williamdnelson10-bot/custom-loudspeakers/Photos/Misc/front_speaker1.jpeg

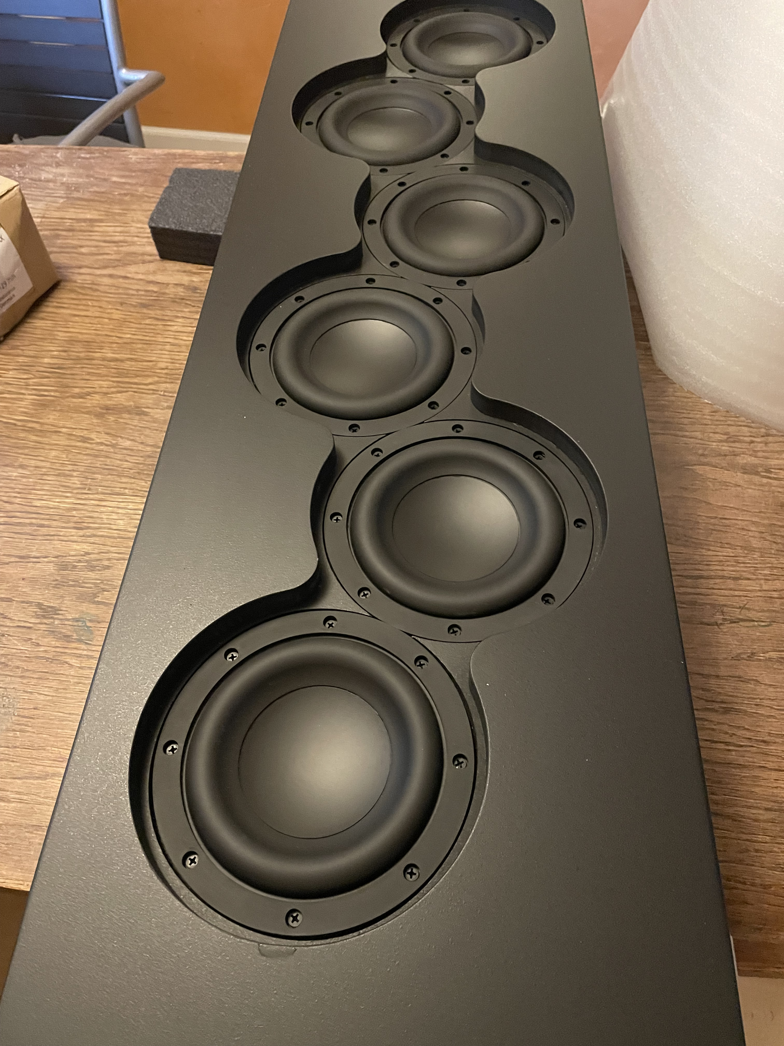
Photos/Misc/front_speaker1.jpeg
