williamdnelson10-bot/custom-loudspeakers/Photos/Misc/IMG_4796.jpeg

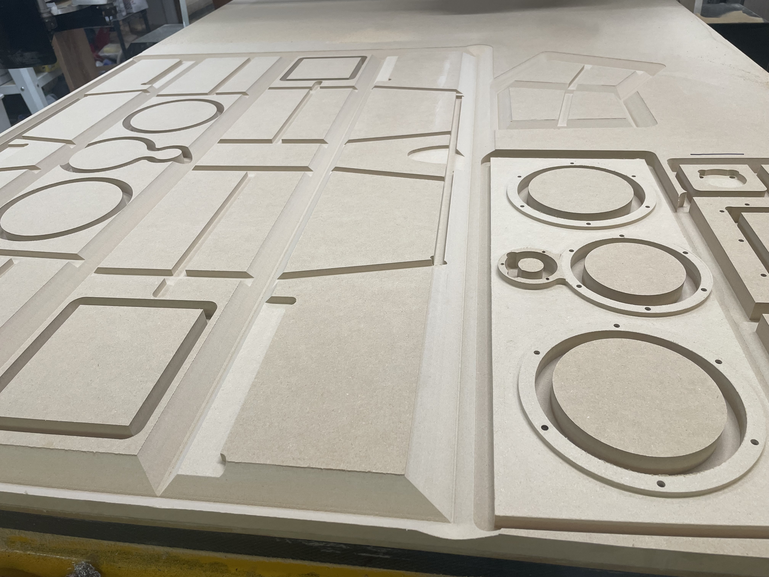
Photos/Misc/IMG_4796.jpeg
