williamdnelson10-bot/custom-loudspeakers/Photos/Misc/IMG_4868.jpeg

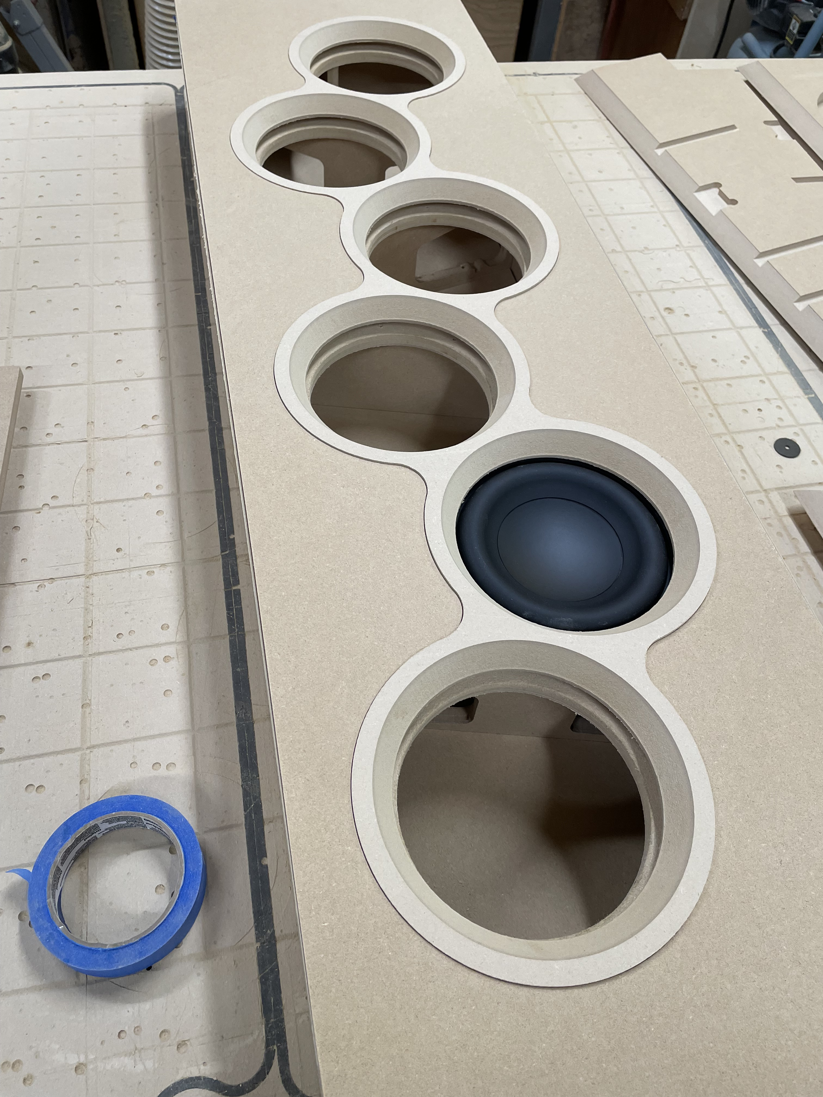
Photos/Misc/IMG_4868.jpeg
