williamdnelson10-bot/custom-loudspeakers/Photos/Misc/IMG_4891.jpeg

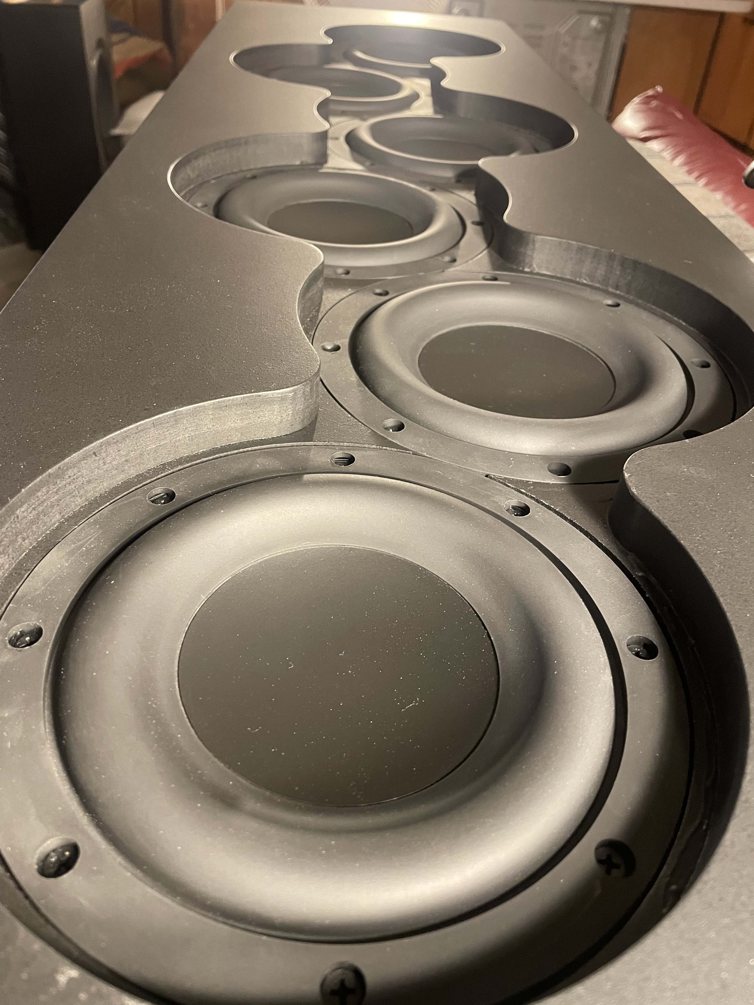
Photos/Misc/IMG_4891.jpeg
