williamdnelson10-bot/custom-loudspeakers/Photos/Misc/IMG_4894.jpeg

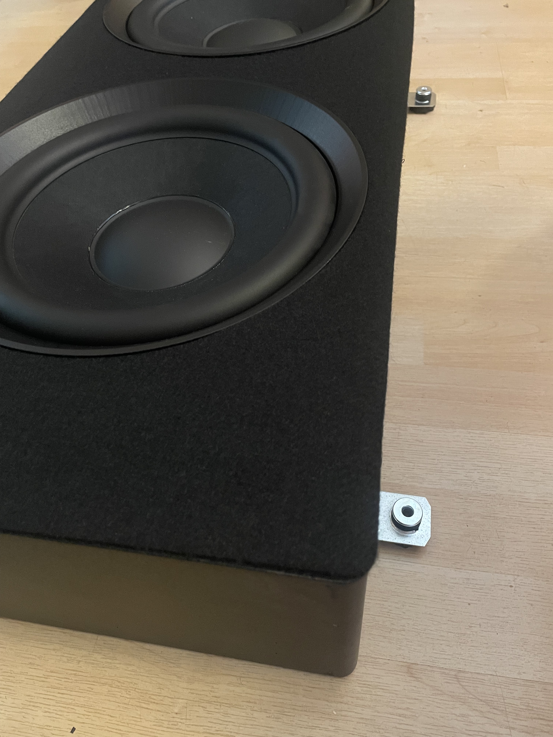
Photos/Misc/IMG_4894.jpeg
