williamdnelson10-bot/custom-loudspeakers/Photos/Misc/IMG_4895.jpeg

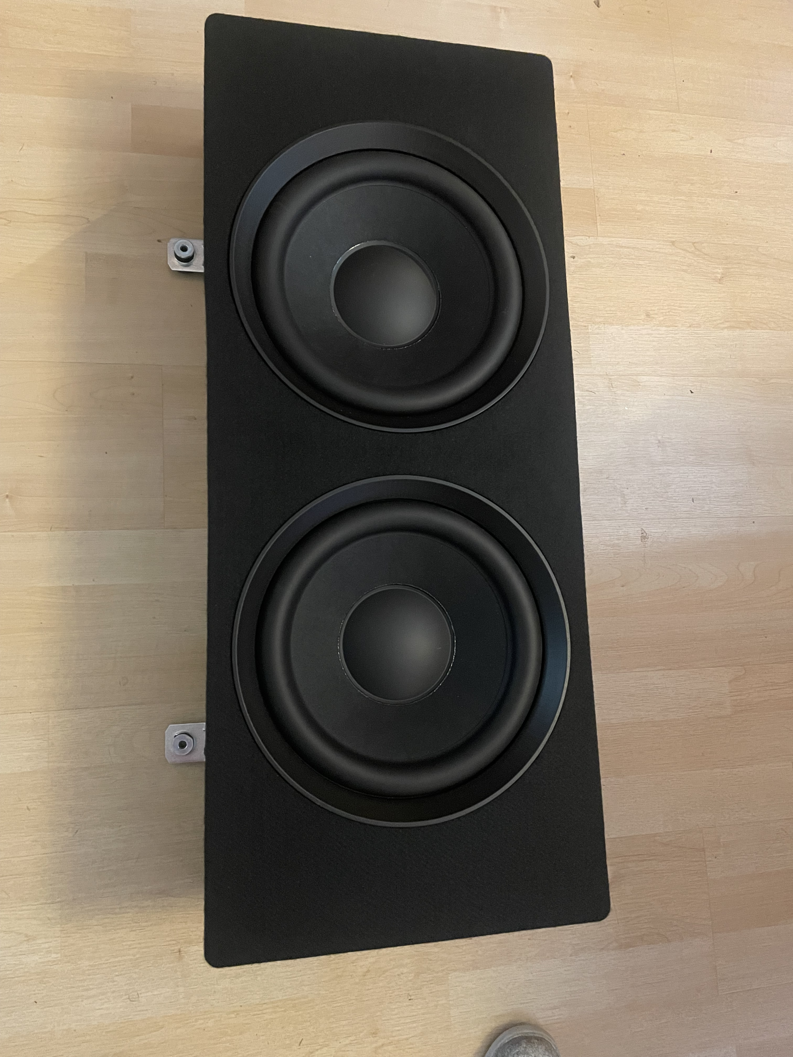
Photos/Misc/IMG_4895.jpeg
