williamdnelson10-bot/custom-loudspeakers/Photos/Misc/IMG_4914.jpeg

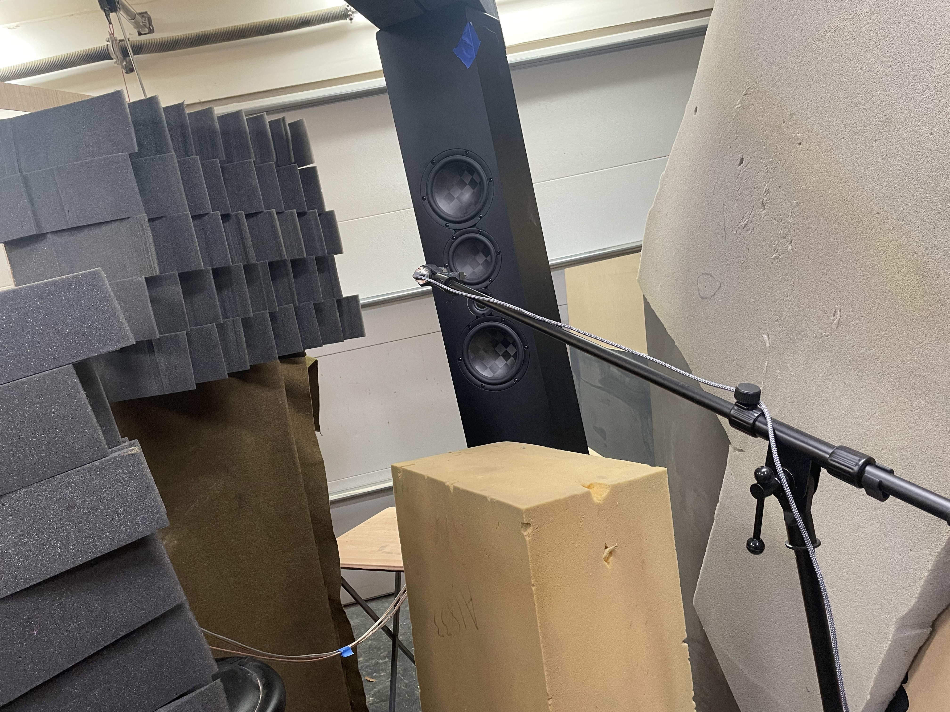
Photos/Misc/IMG_4914.jpeg
