williamdnelson10-bot/custom-loudspeakers/Photos/Misc/IMG_4917.jpeg

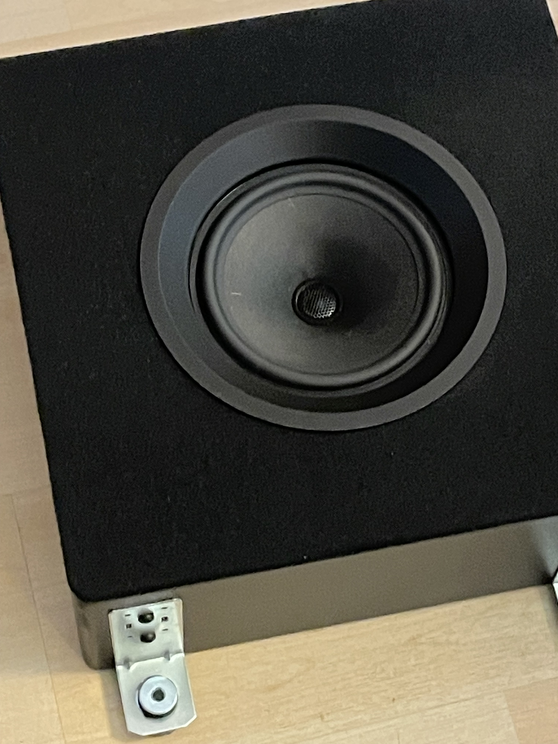
Photos/Misc/IMG_4917.jpeg
