williamdnelson10-bot/custom-loudspeakers/Photos/Misc/IMG_4919.jpeg

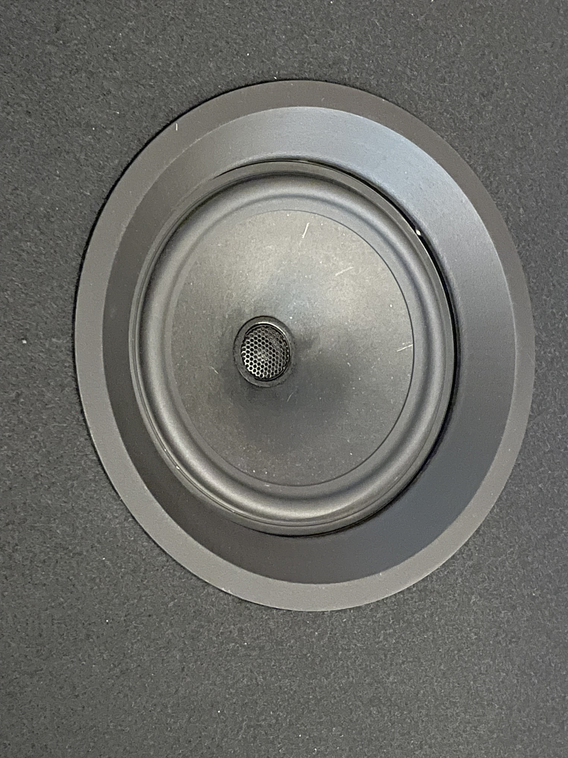
Photos/Misc/IMG_4919.jpeg
