williamdnelson10-bot/custom-loudspeakers/Photos/Misc/IMG_4920.jpeg

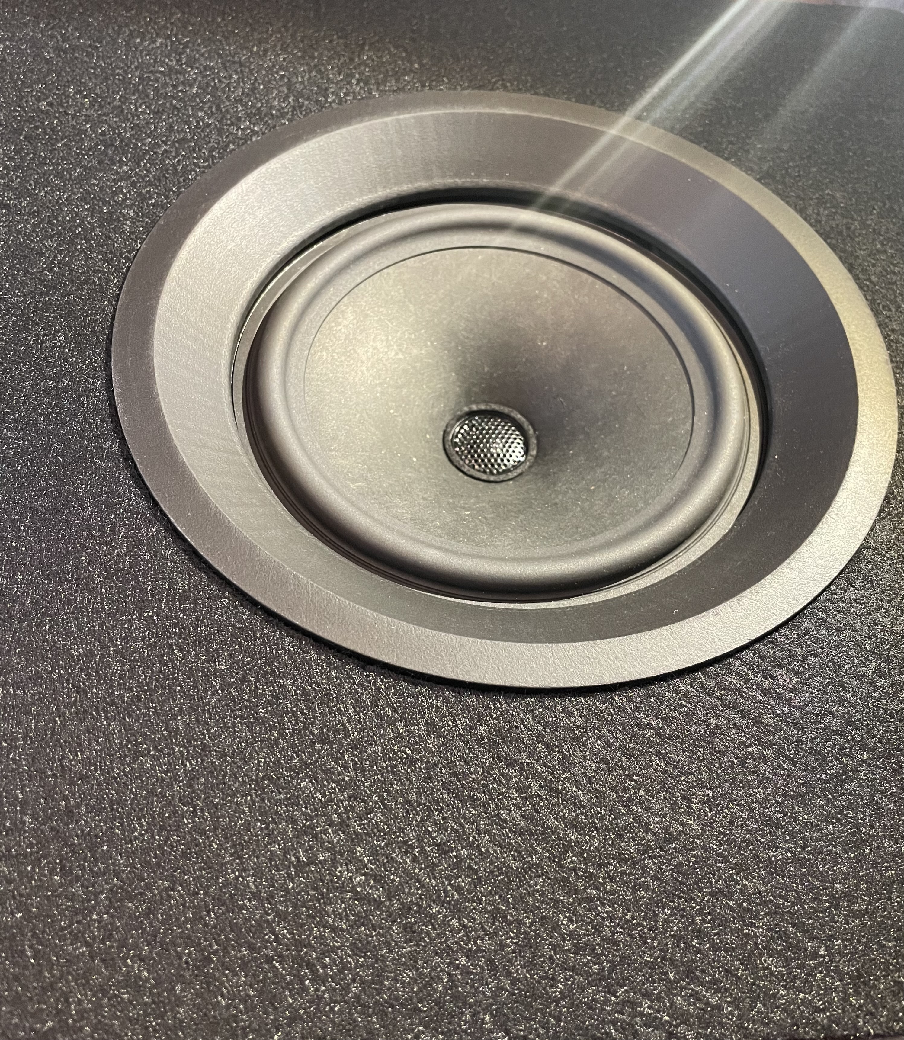
Photos/Misc/IMG_4920.jpeg
