williamdnelson10-bot/custom-loudspeakers/Photos/Misc/IMG_4924.jpeg

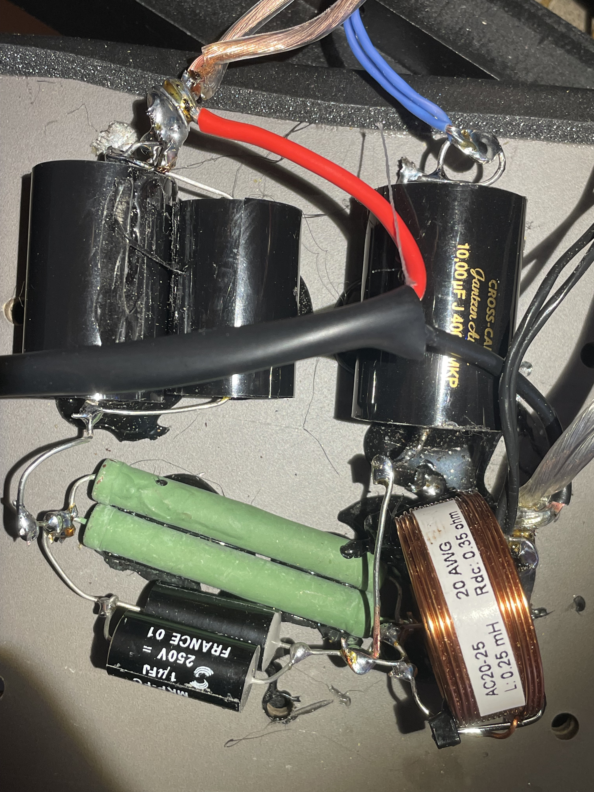
Photos/Misc/IMG_4924.jpeg
