williamdnelson10-bot/custom-loudspeakers/Photos/Misc/IMG_4925.jpeg

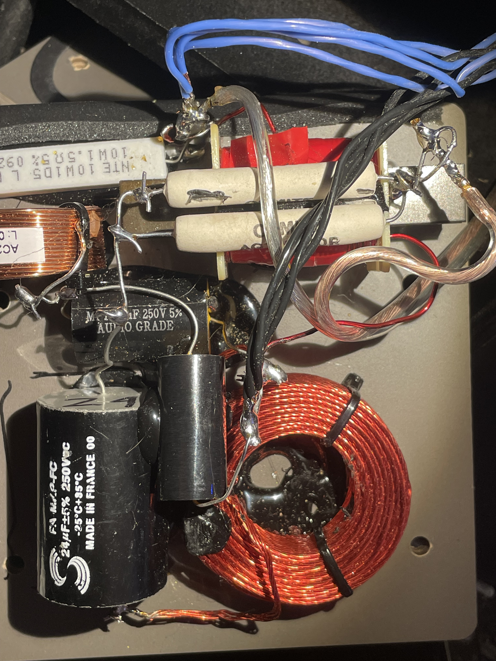
Photos/Misc/IMG_4925.jpeg
