williamdnelson10-bot/custom-loudspeakers/Photos/Misc/IMG_4938.jpeg

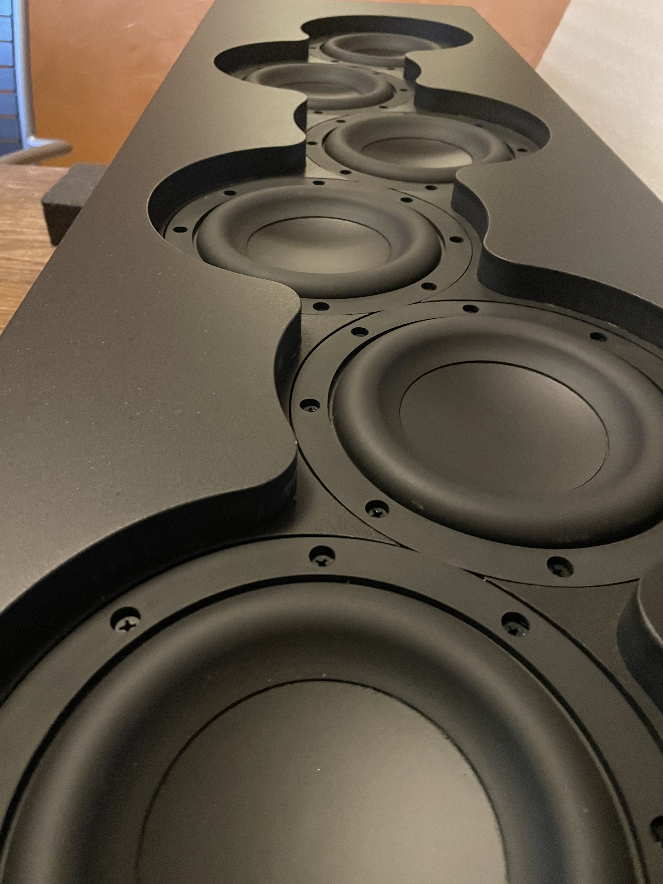
Photos/Misc/IMG_4938.jpeg
