williamdnelson10-bot/custom-loudspeakers/Photos/Misc/IMG_5594.jpg

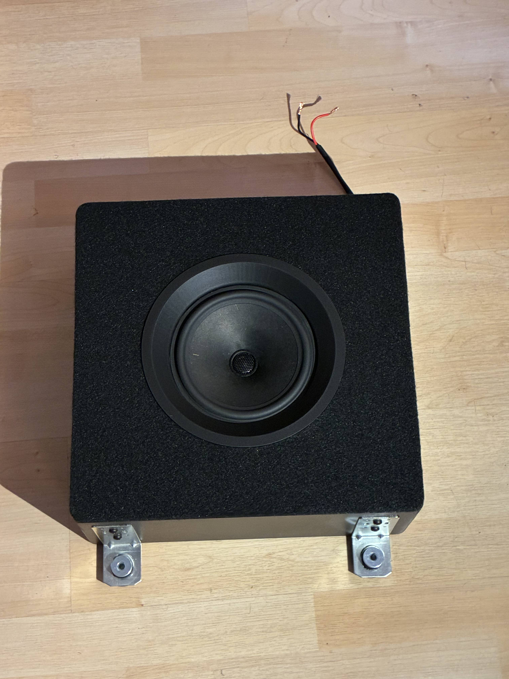
Photos/Misc/IMG_5594.jpg
