williamdnelson10-bot/custom-loudspeakers/Photos/Misc/IMG_5603.jpg

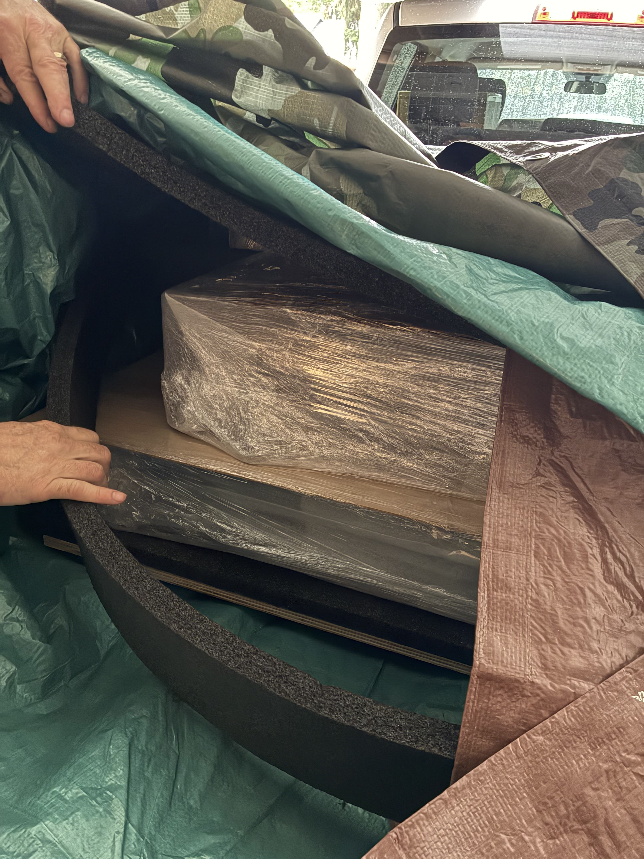
Photos/Misc/IMG_5603.jpg
