williamdnelson10-bot/custom-loudspeakers/Solidworks Files/SB6 Sur.SLDASM

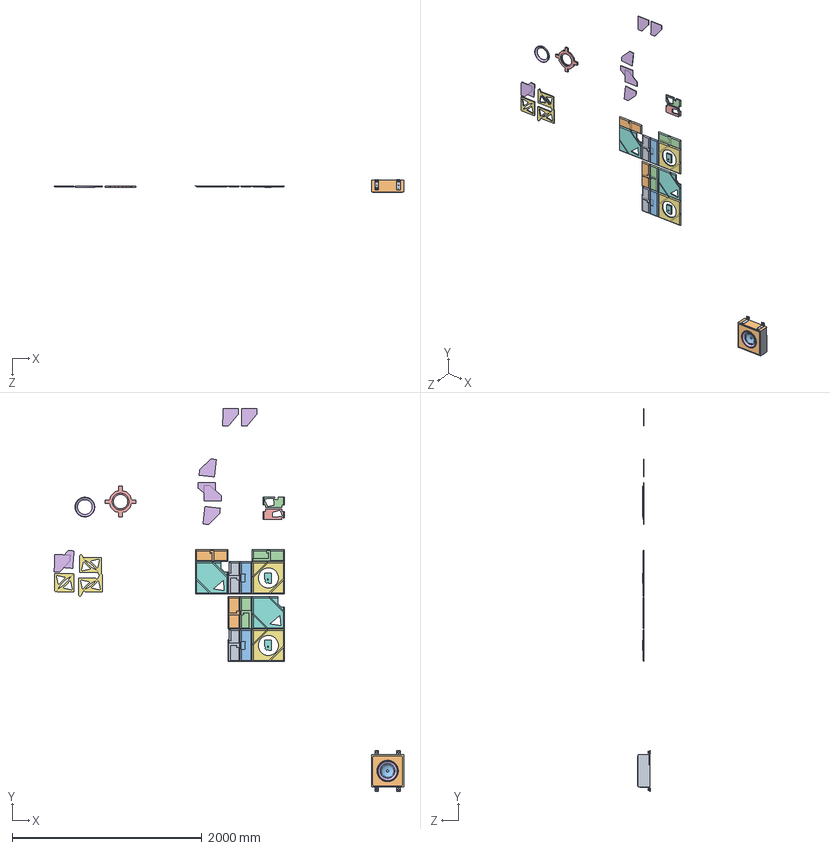
[picture p39: CAD file, 2026-11-06]
Solidworks Files/SB6 Sur.SLDASM
3684.7 x 4034.4 x 137.4 mm
SB6 Sur Back x 2
SB6 Sur Front x 3
SB6 Sur RIng x 2
SB6 Driver ring x 2
SB6 Sur Bottom x 3
SB6 Sur Side x 3
SB6 Sur Top x 3
SB6 Sur Side2 x 3
Sur BP Plate x 3
SB6 XOB Ring x 7
SB6 XO Board x 9
SB6 Sur Brace1 x 2
SB6 Sur Brace2 x 2
SB16 6in Coax
SB6 Sur Pad
PAC Intl RSIC-DC04 Bracket x 4
