williamdnelson10-bot/custom-loudspeakers/Solidworks Files/SB6 XO Board.SLDPRT

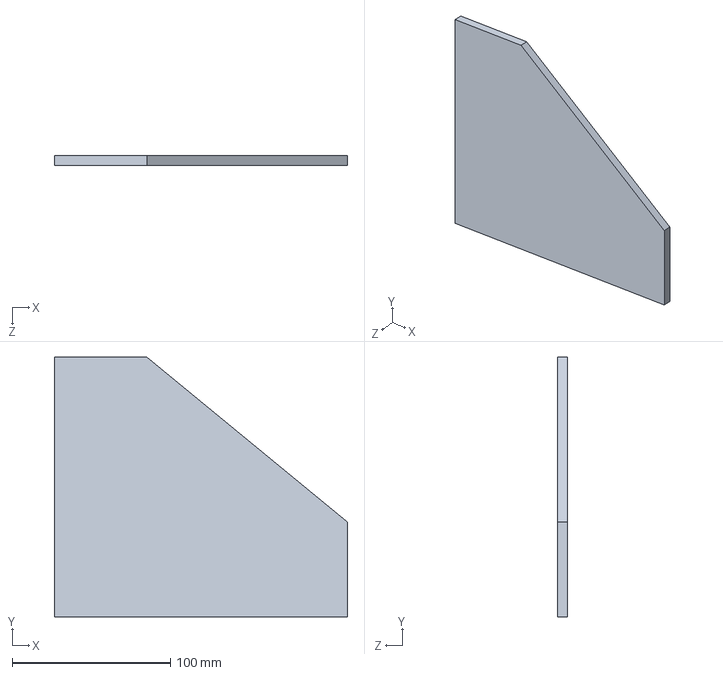
[picture p40: CAD file, 2026-11-06]
Solidworks Files/SB6 XO Board.SLDPRT
185.0 x 164.0 x 6.35 mm
