williamdnelson10-bot/custom-loudspeakers/Solidworks Files/SB6 Sur Side.SLDPRT

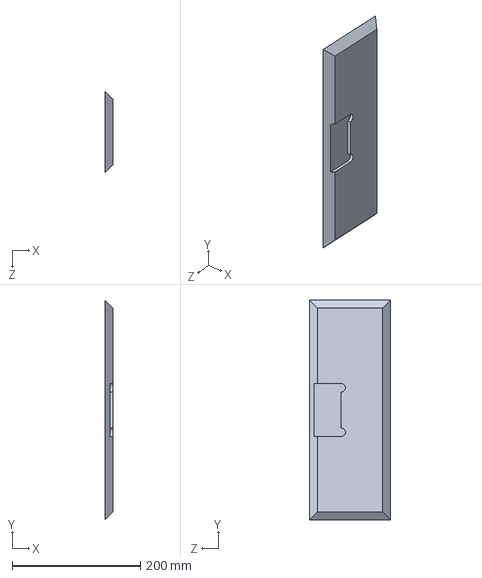
[picture p41: CAD file, 2026-11-06]
Solidworks Files/SB6 Sur Side.SLDPRT
12.7 x 342.9 x 127.0 mm
