williamdnelson10-bot/custom-loudspeakers/Solidworks Files/SB6 Sur Bottom.SLDPRT

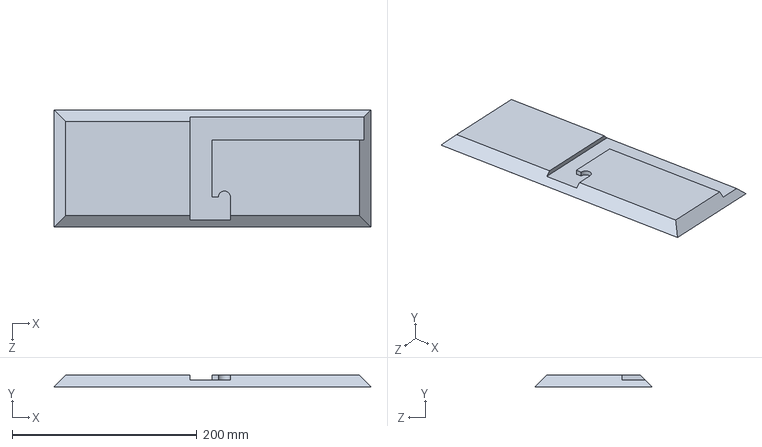
[picture p42: CAD file, 2026-11-06]
Solidworks Files/SB6 Sur Bottom.SLDPRT
342.9 x 12.7 x 127.0 mm
