williamdnelson10-bot/custom-loudspeakers/Solidworks Files/SB6 Sur Pad.SLDPRT

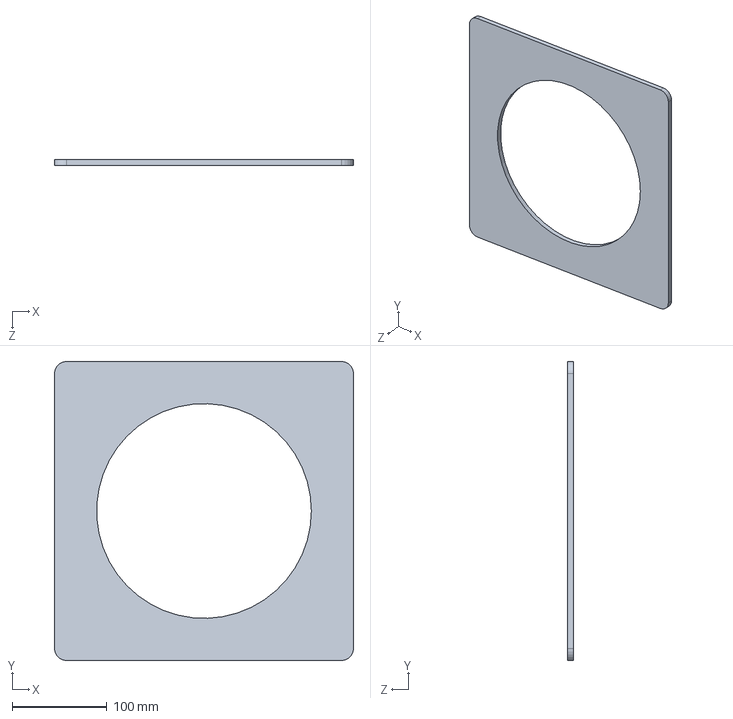
[picture p43: CAD file, 2026-11-06]
Solidworks Files/SB6 Sur Pad.SLDPRT
315.3 x 315.3 x 6.35 mm
