williamdnelson10-bot/custom-loudspeakers/Solidworks Files/SB6 Sur RIng.SLDPRT

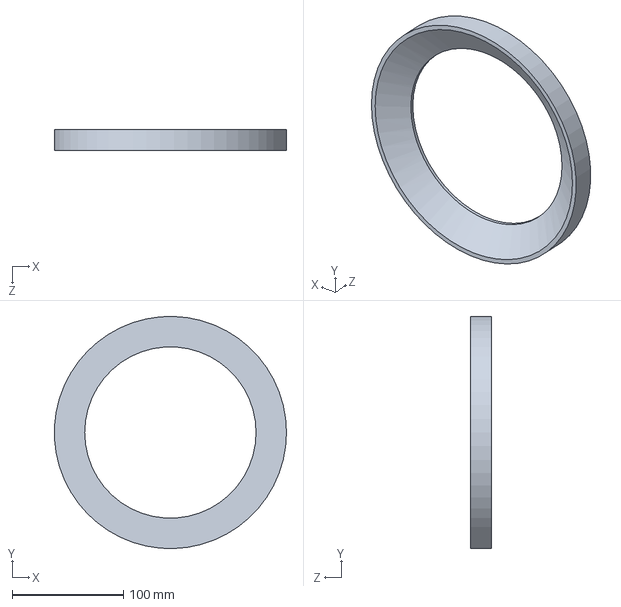
[picture p44: CAD file, 2026-11-06]
Solidworks Files/SB6 Sur RIng.SLDPRT
208.8 x 208.9 x 19.1 mm
