williamdnelson10-bot/custom-loudspeakers/Solidworks Files/PAC Intl RSIC-DC04 Bracket.sldprt

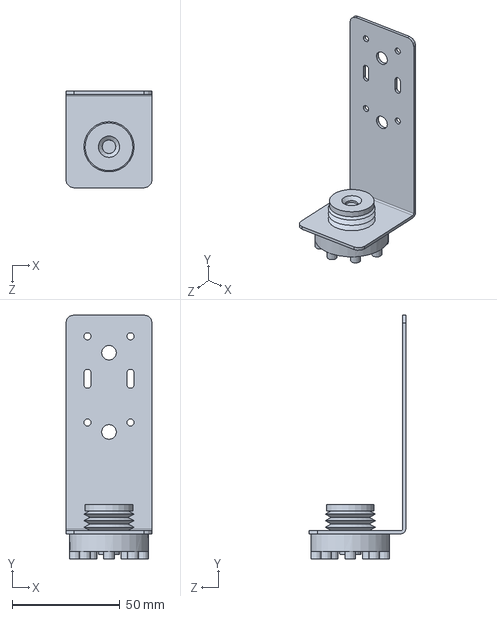
[picture p45: CAD file, 2026-11-06]
Solidworks Files/PAC Intl RSIC-DC04 Bracket.sldprt
40.1 x 113.3 x 44.9 mm
