williamdnelson10-bot/custom-loudspeakers/Solidworks Files/SB6 Sur Side2.SLDPRT

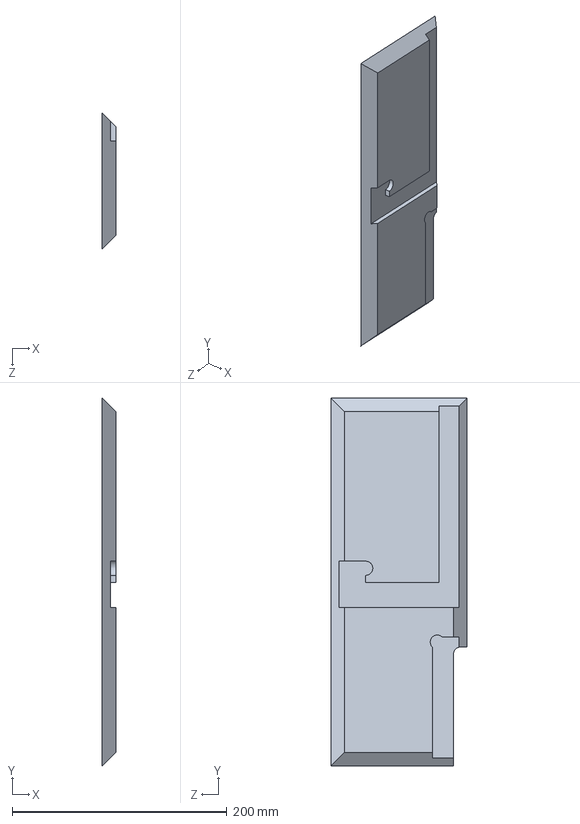
[picture p46: CAD file, 2026-11-06]
Solidworks Files/SB6 Sur Side2.SLDPRT
12.7 x 342.9 x 127.0 mm
