williamdnelson10-bot/custom-loudspeakers/Solidworks Files/SB16 6in Coax.SLDPRT

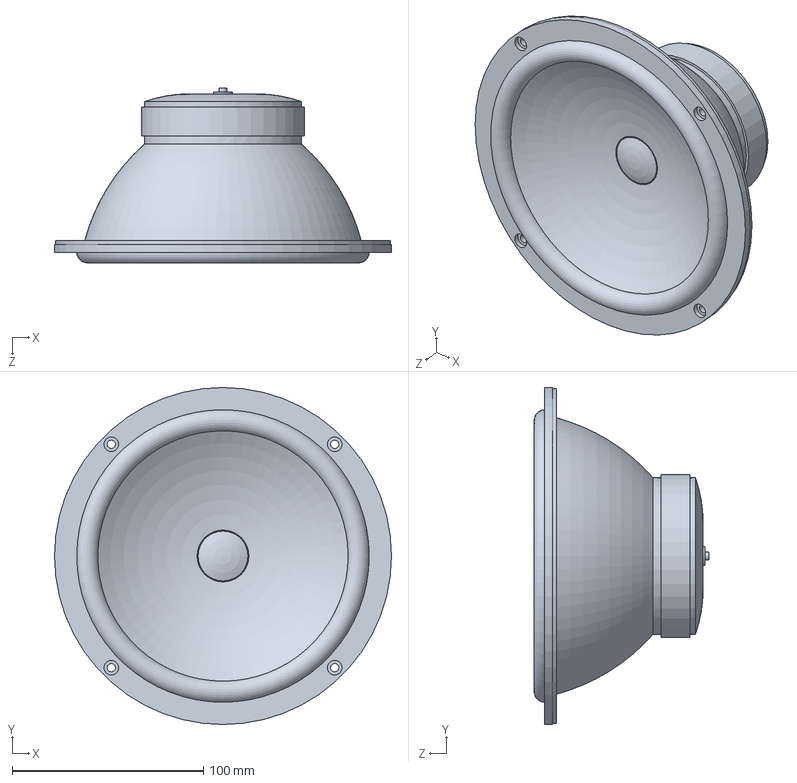
[picture p47: CAD file, 2026-11-06]
Solidworks Files/SB16 6in Coax.SLDPRT
176.0 x 176.0 x 91.3 mm
