williamdnelson10-bot/custom-loudspeakers/Solidworks Files/SB6 Sur Front.SLDPRT

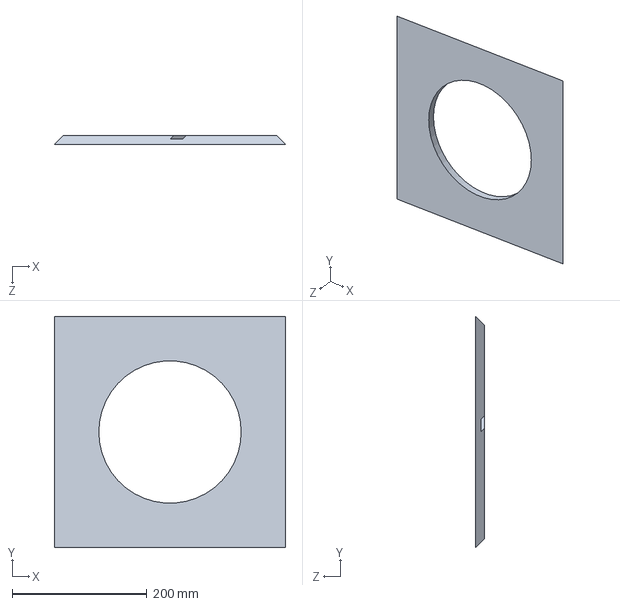
[picture p48: CAD file, 2026-11-06]
Solidworks Files/SB6 Sur Front.SLDPRT
342.9 x 342.9 x 12.7 mm
