williamdnelson10-bot/custom-loudspeakers/Solidworks Files/SB6 Sur Back.SLDPRT

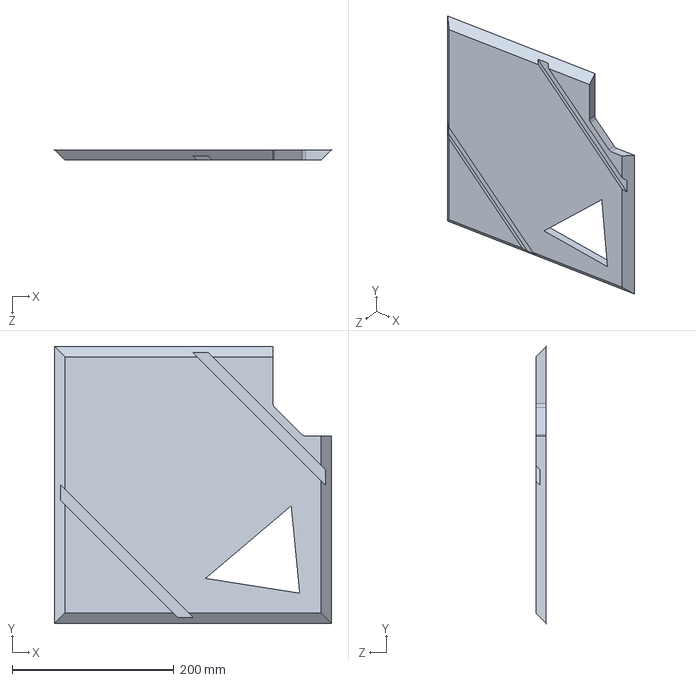
[picture p49: CAD file, 2026-11-06]
Solidworks Files/SB6 Sur Back.SLDPRT
342.9 x 342.9 x 12.7 mm
