williamdnelson10-bot/custom-loudspeakers/Solidworks Files/SB6 PART.SLDPRT

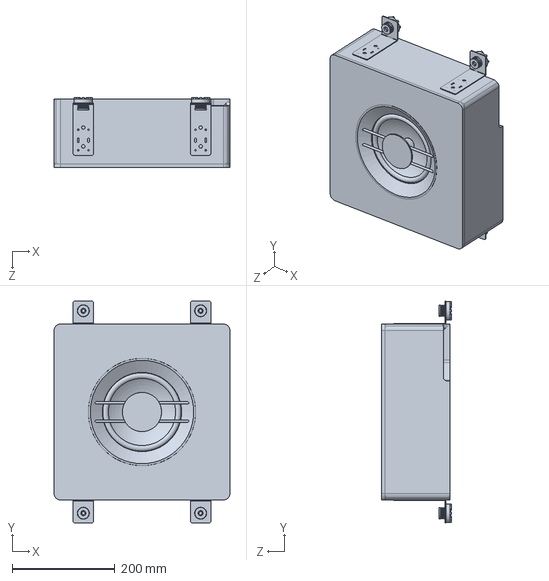
[picture p50: CAD file, 2026-11-06]
Solidworks Files/SB6 PART.SLDPRT
342.9 x 432.7 x 137.4 mm
