williamdnelson10-bot/custom-loudspeakers/Solidworks Files/SB6 XOB Ring.SLDPRT

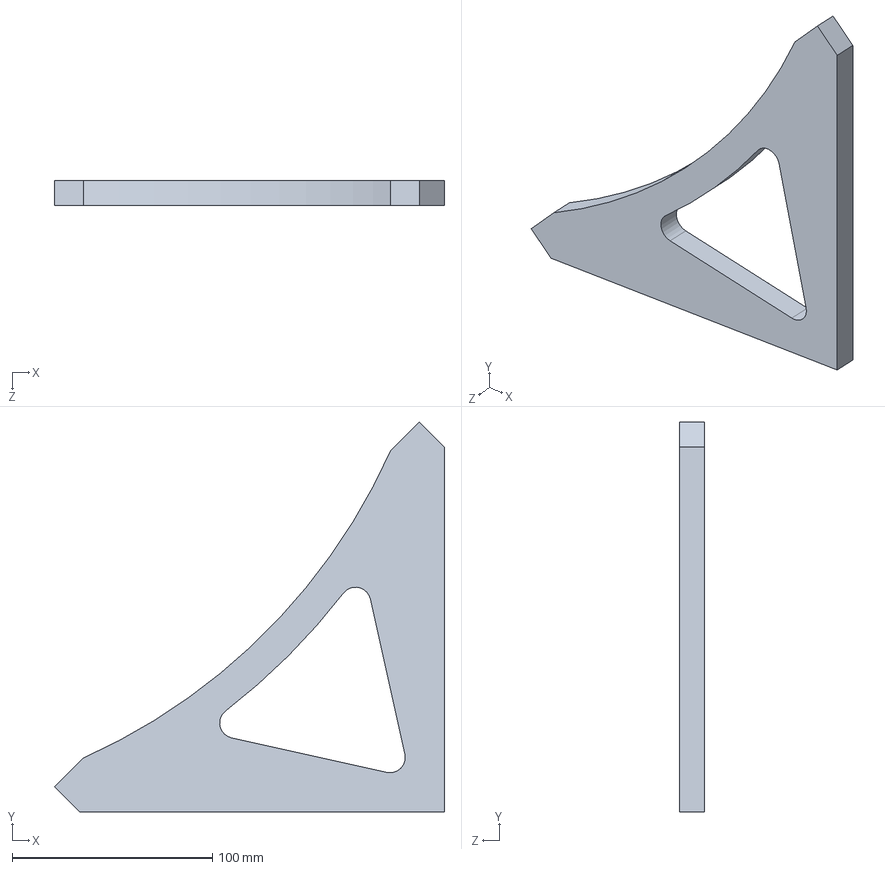
[picture p51: CAD file, 2026-11-06]
Solidworks Files/SB6 XOB Ring.SLDPRT
194.9 x 194.9 x 12.7 mm
