williamdnelson10-bot/custom-loudspeakers/Solidworks Files/SB6 Sur Brace1.SLDPRT

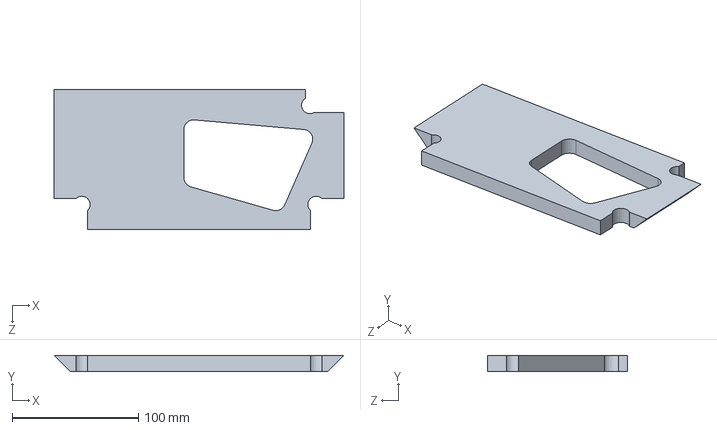
[picture p52: CAD file, 2026-11-06]
Solidworks Files/SB6 Sur Brace1.SLDPRT
229.6 x 12.7 x 111.0 mm
