williamdnelson10-bot/custom-loudspeakers/Solidworks Files/Sur BP Plate.SLDPRT

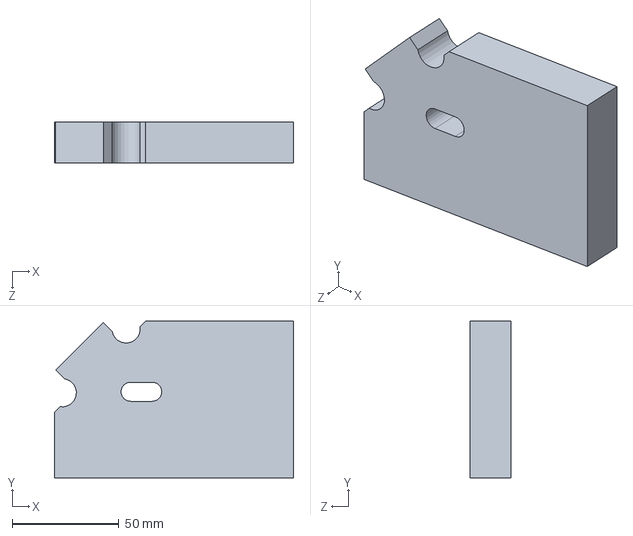
[picture p53: CAD file, 2026-11-06]
Solidworks Files/Sur BP Plate.SLDPRT
111.8 x 73.3 x 19.1 mm
