williamdnelson10-bot/custom-loudspeakers/Solidworks Files/SB6 Driver ring.SLDPRT

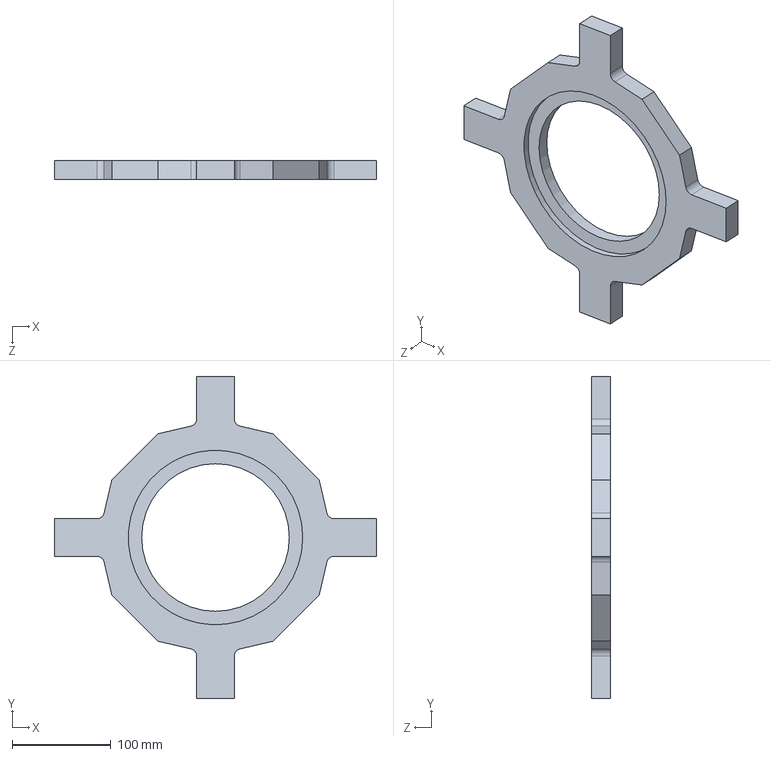
[picture p54: CAD file, 2026-11-06]
Solidworks Files/SB6 Driver ring.SLDPRT
326.9 x 326.9 x 19.1 mm
