williamdnelson10-bot/custom-loudspeakers/Solidworks Files/SB6 Sur Brace2.SLDPRT

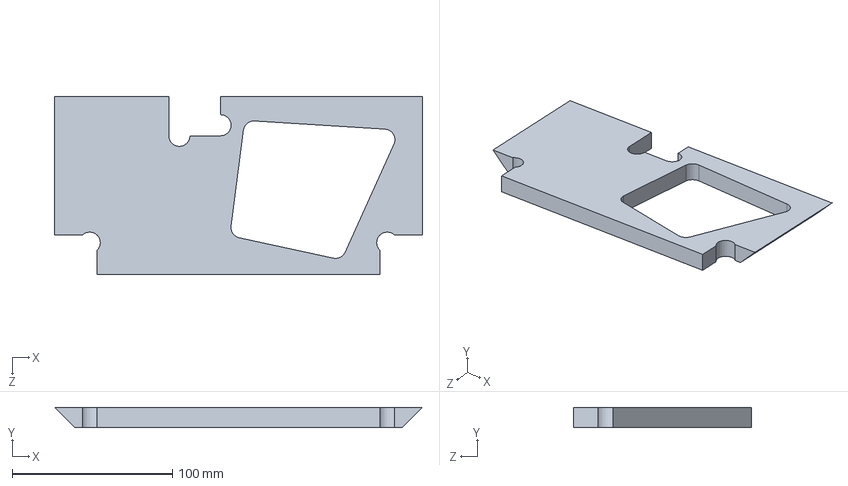
[picture p55: CAD file, 2026-11-06]
Solidworks Files/SB6 Sur Brace2.SLDPRT
229.6 x 12.7 x 111.0 mm
