williamdnelson10-bot/custom-loudspeakers/(list of files, cad)

Other CAD files:
Solidworks Files/SB6 Sur Top.SLDPRT
Solidworks Files/MirrorSB6 Sur Side.SLDPRT
