williamdnelson10-bot/custom-loudspeakers/Photos/Misc/IMG_4795.jpeg

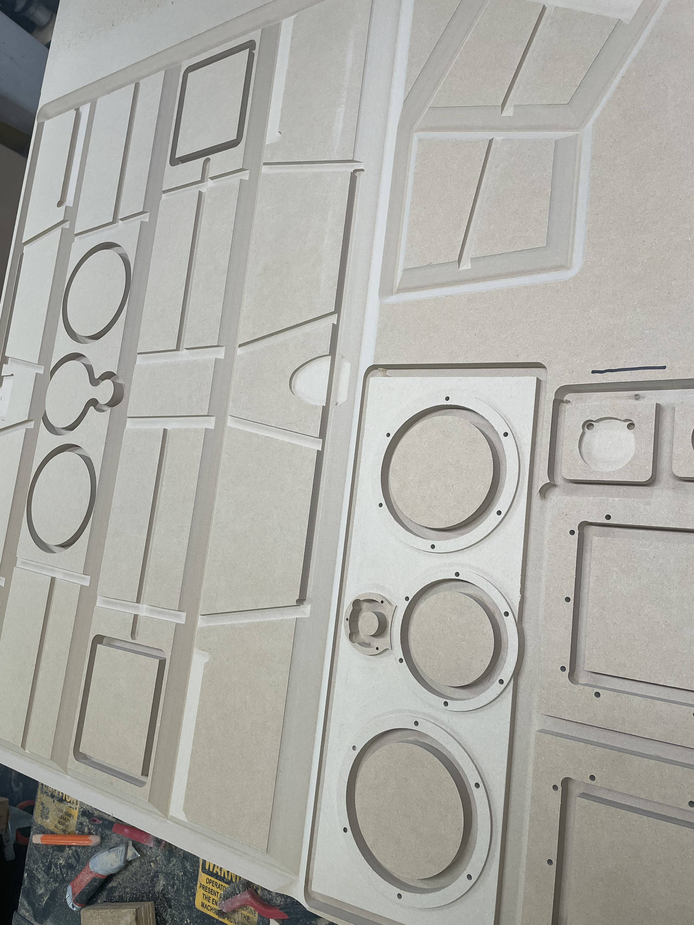
Photos/Misc/IMG_4795.jpeg
