williamdnelson10-bot/custom-loudspeakers/Photos/Misc/IMG_4797.jpeg

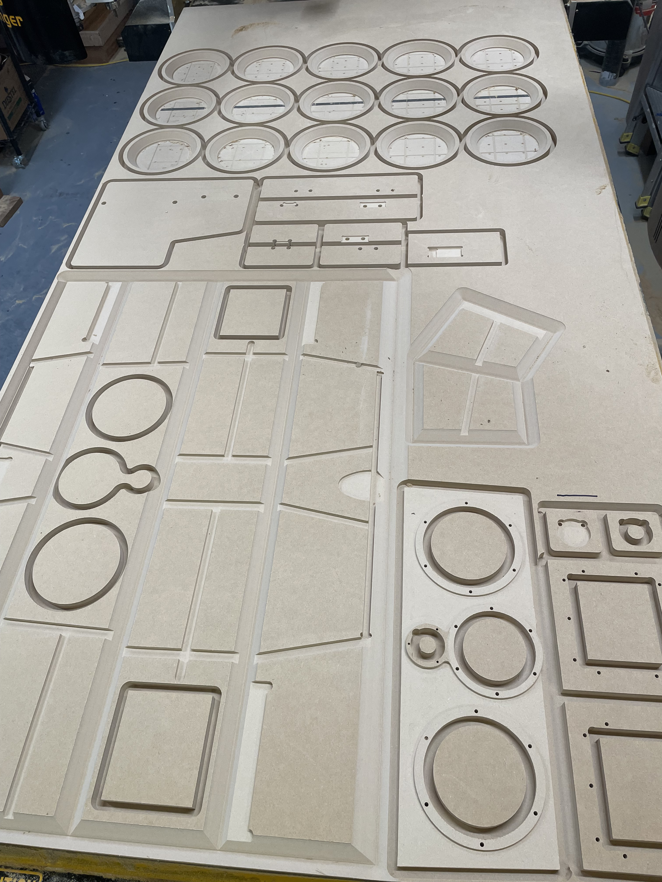
Photos/Misc/IMG_4797.jpeg
