williamdnelson10-bot/custom-loudspeakers/Photos/Misc/IMG_4820.jpeg

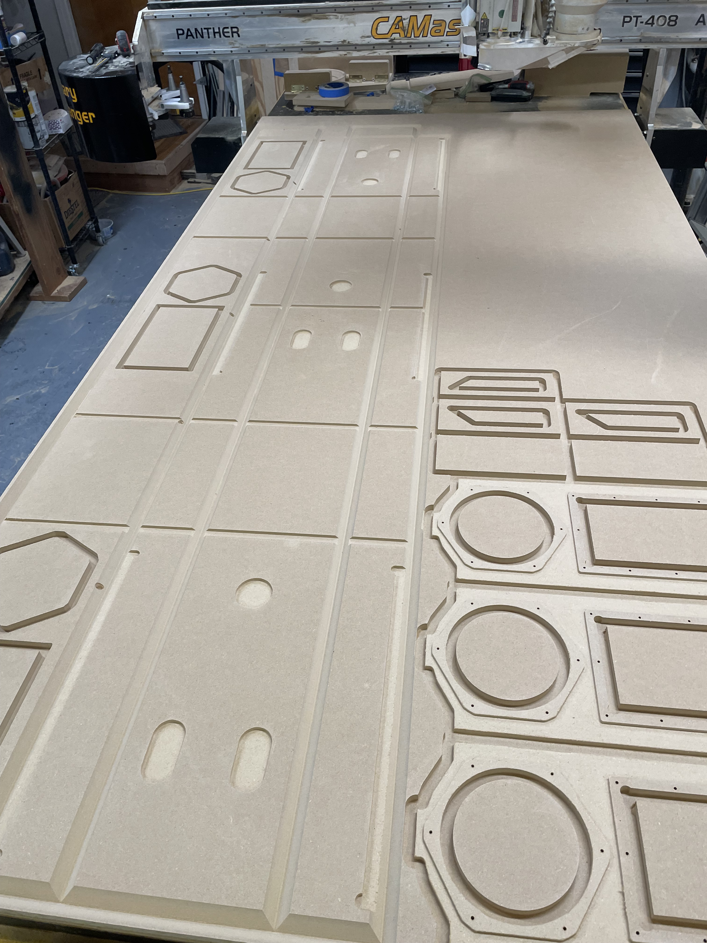
Photos/Misc/IMG_4820.jpeg
