williamdnelson10-bot/custom-loudspeakers/Photos/Misc/IMG_4908.jpeg

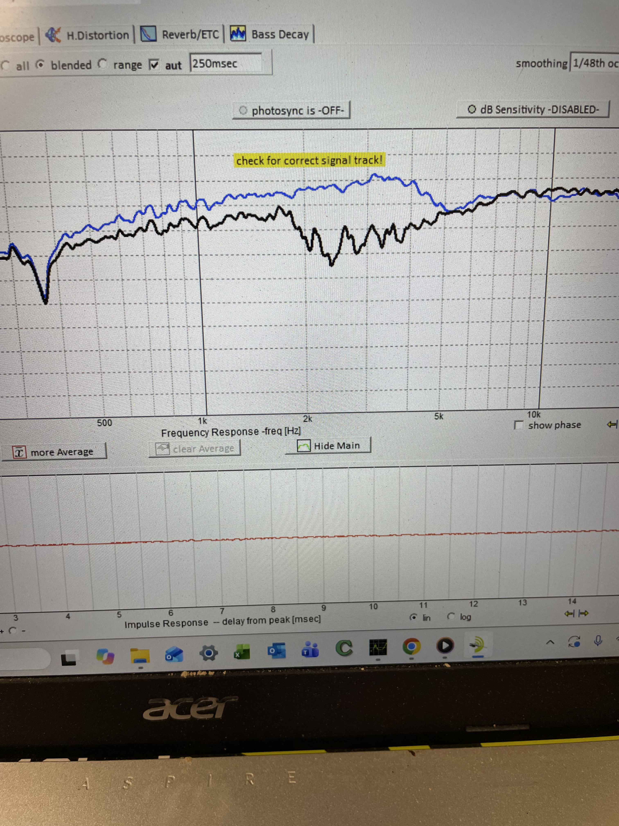
Photos/Misc/IMG_4908.jpeg
