williamdnelson10-bot/custom-loudspeakers/Photos/Misc/IMG_4979.jpeg

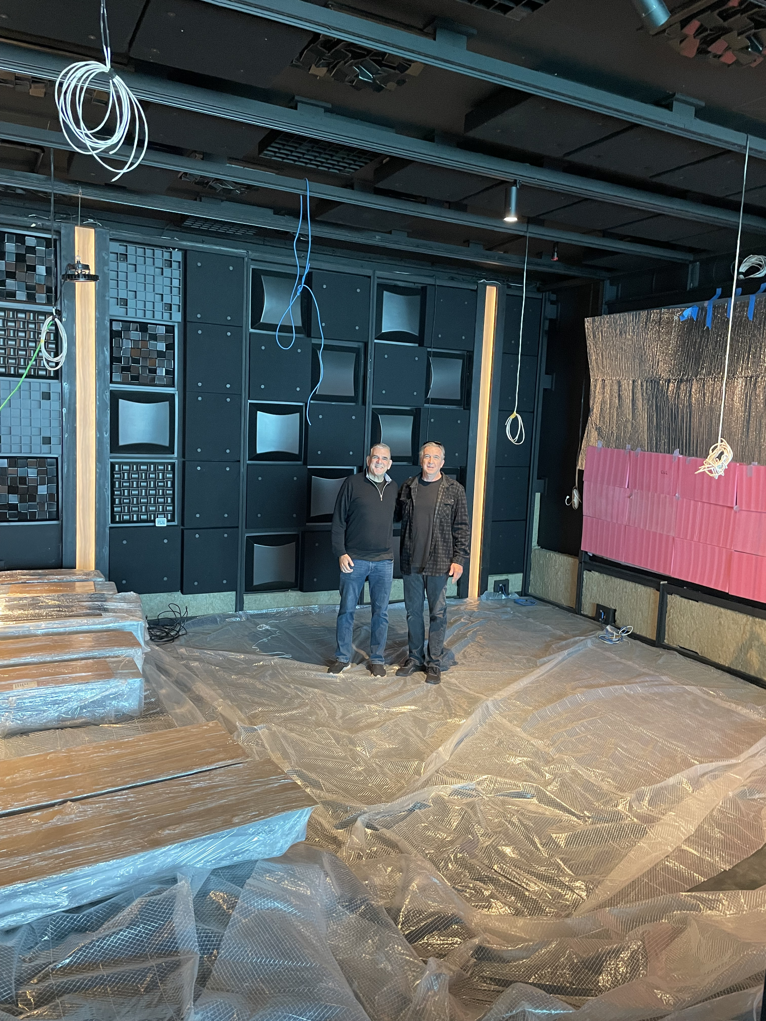
Photos/Misc/IMG_4979.jpeg
