williamdnelson10-bot/custom-loudspeakers/Photos/Misc/IMG_4980.jpeg

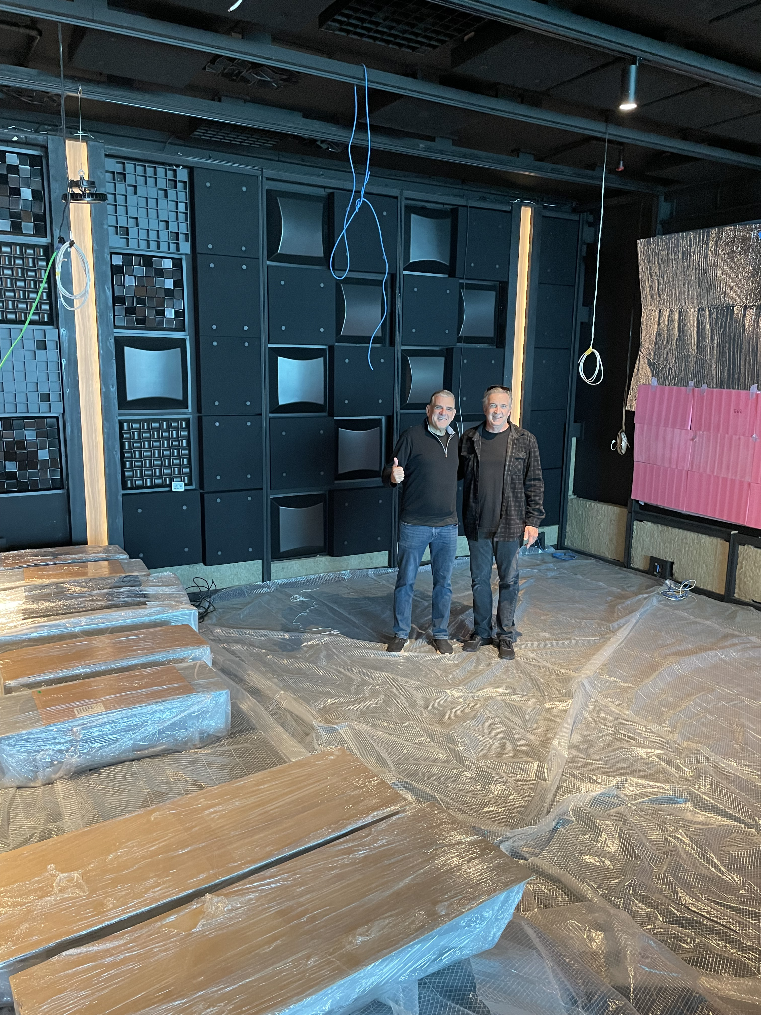
Photos/Misc/IMG_4980.jpeg
