williamdnelson10-bot/custom-loudspeakers/Photos/Misc/IMG_5401.jpg

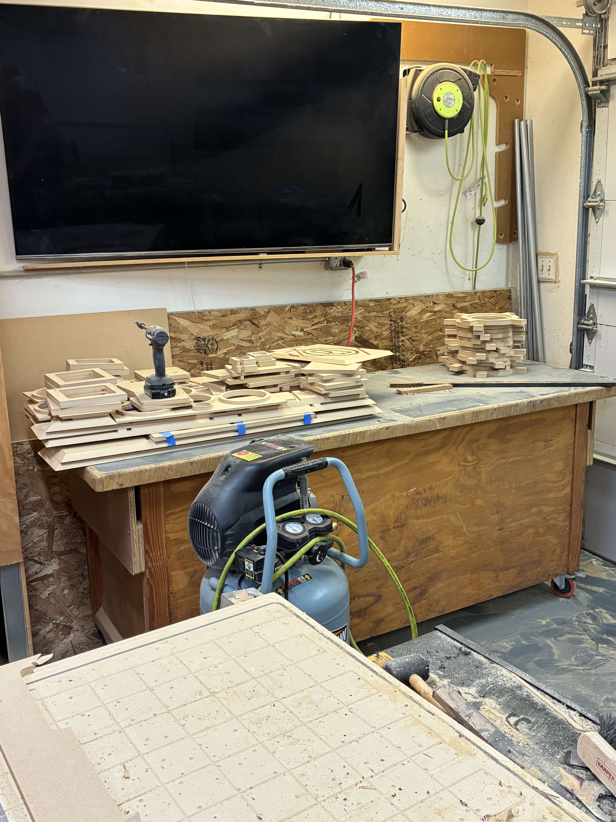
Photos/Misc/IMG_5401.jpg
