williamdnelson10-bot/custom-loudspeakers/Photos/Misc/IMG_5402.jpg

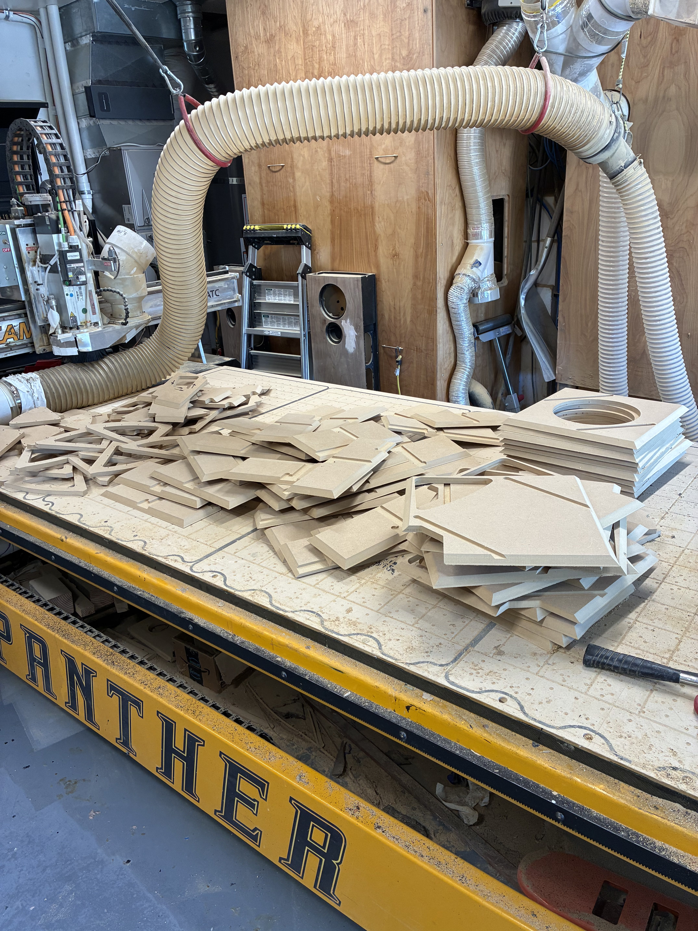
Photos/Misc/IMG_5402.jpg
