williamdnelson10-bot/custom-loudspeakers/Photos/Misc/IMG_5418.jpg

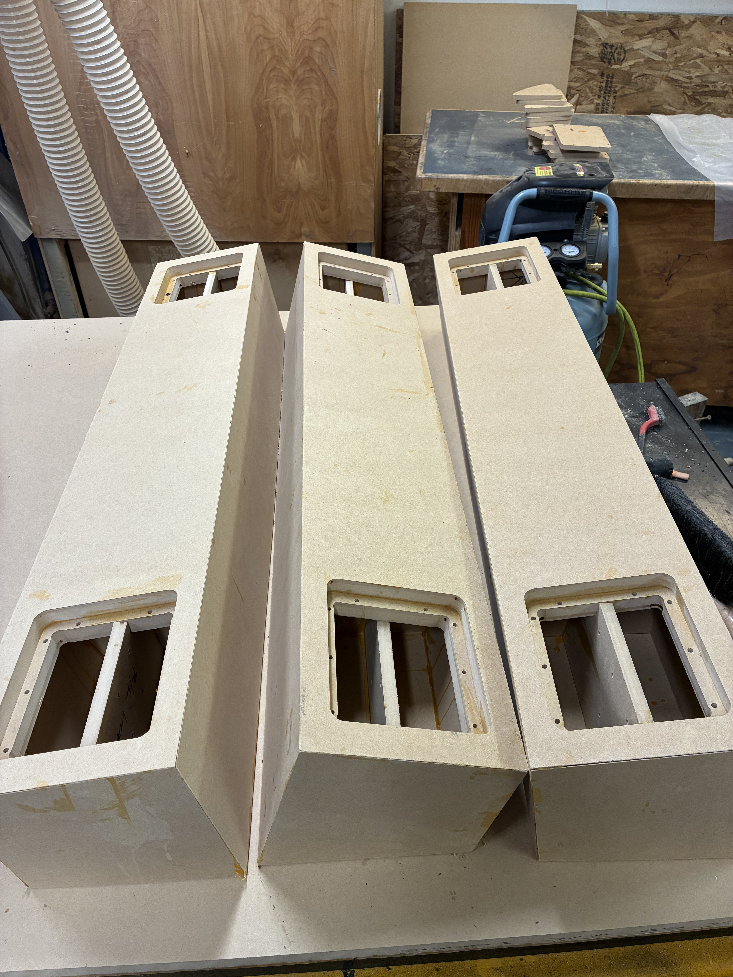
Photos/Misc/IMG_5418.jpg
