williamdnelson10-bot/custom-loudspeakers/Photos/Misc/IMG_5428.jpg

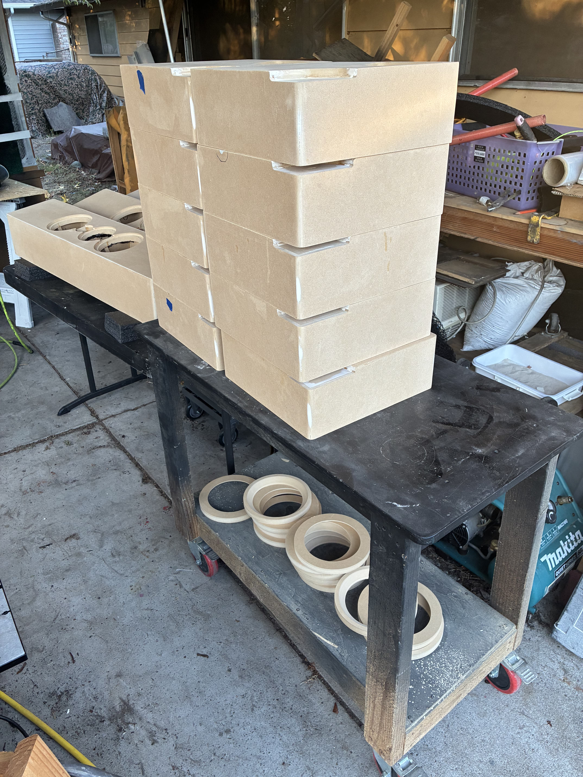
Photos/Misc/IMG_5428.jpg
