williamdnelson10-bot/custom-loudspeakers/Photos/Misc/IMG_5431.jpg

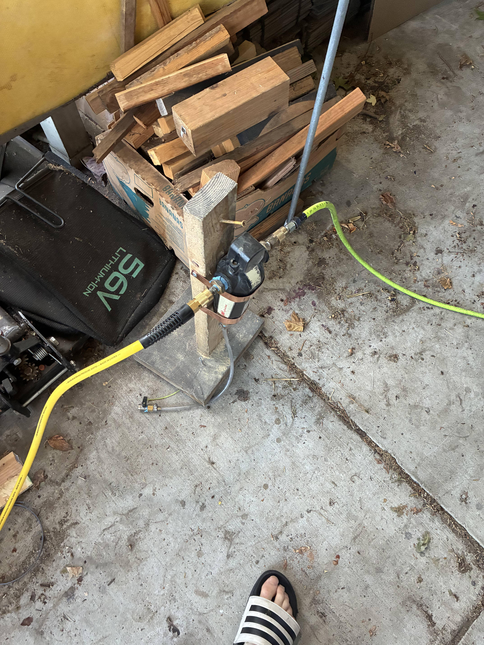
Photos/Misc/IMG_5431.jpg
