williamdnelson10-bot/custom-loudspeakers/Photos/Main Photos/surround_parts.jpg

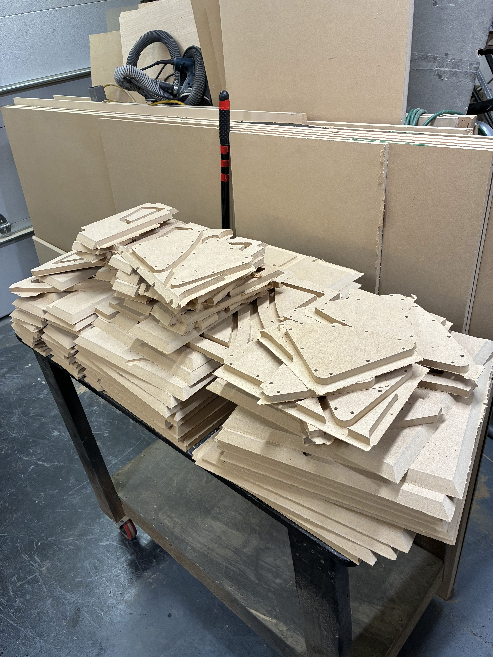
Photos/Main Photos/surround_parts.jpg
