williamdnelson10-bot/custom-loudspeakers/Photos/Main Photos/front_speaker2.jpg

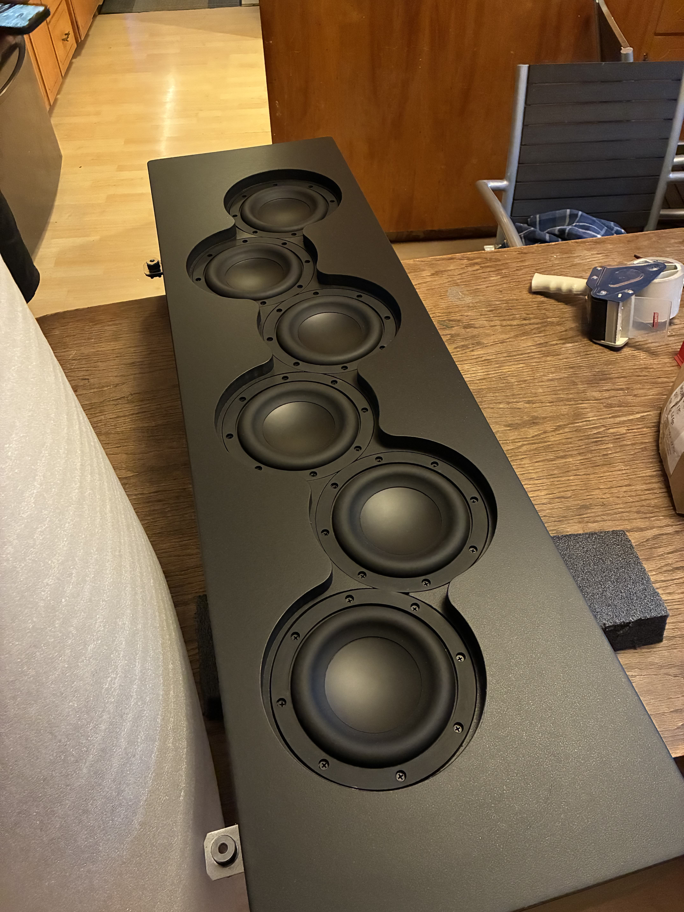
[picture p2: Photos/Main Photos/front_speaker2.jpg]
Photos/Main Photos/front_speaker2.jpg
