williamdnelson10-bot/custom-loudspeakers/Photos/Main Photos/surrounds_unpainted.jpg

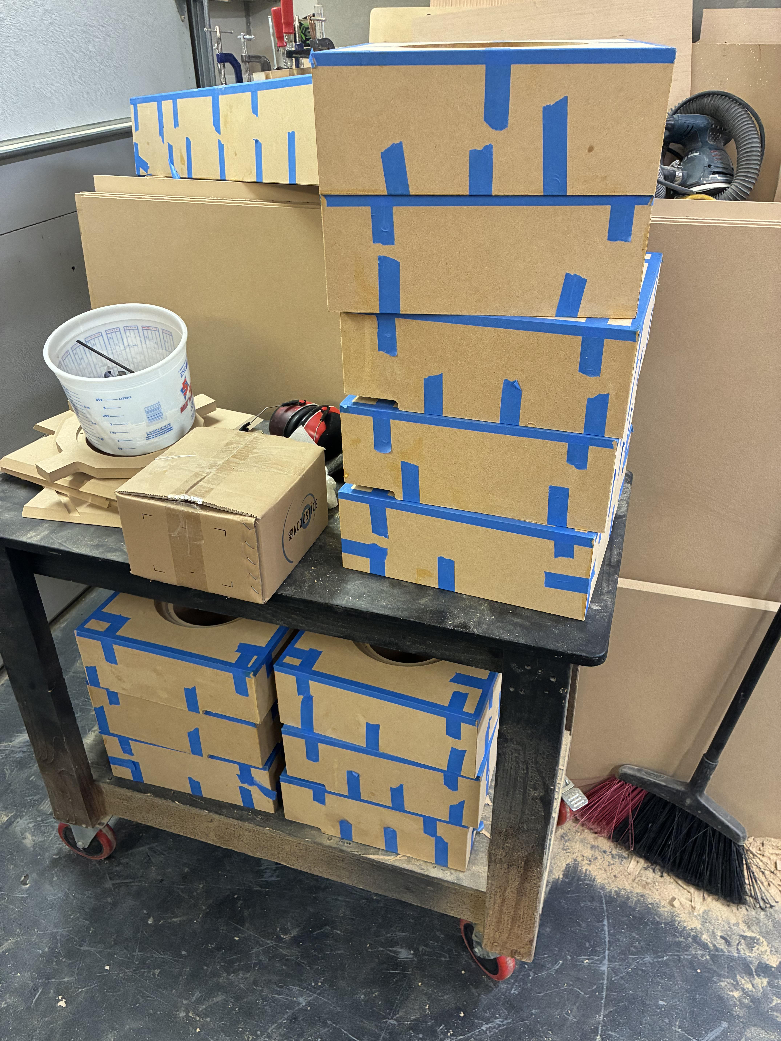
[picture p6: Photos/Main Photos/surrounds_unpainted.jpg]
Photos/Main Photos/surrounds_unpainted.jpg
