williamdnelson10-bot/custom-loudspeakers/Photos/Main Photos/glued_surround.jpg

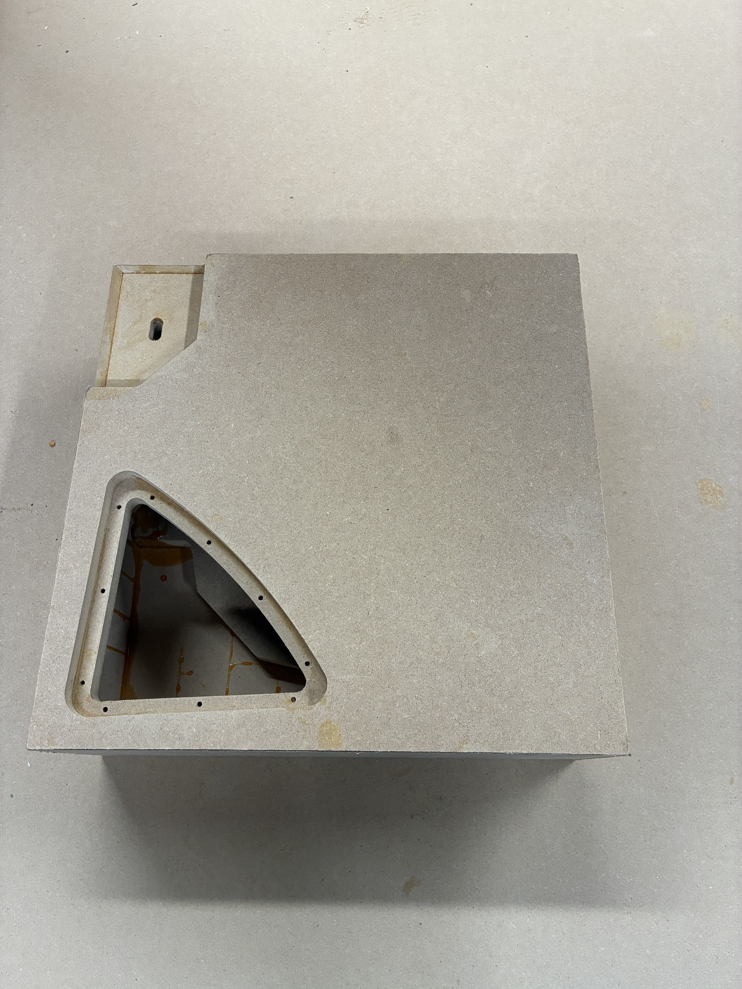
[picture p7: Photos/Main Photos/glued_surround.jpg]
Photos/Main Photos/glued_surround.jpg
