williamdnelson10-bot/custom-loudspeakers/Photos/Main Photos/painting_setup.jpg

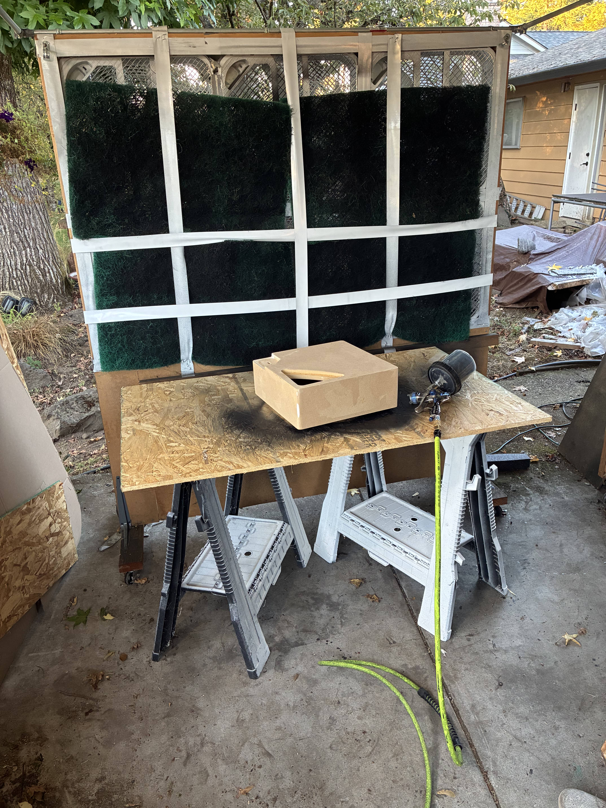
[picture p8: Photos/Main Photos/painting_setup.jpg]
Photos/Main Photos/painting_setup.jpg
