williamdnelson10-bot/custom-loudspeakers/Photos/Main Photos/Surrounds Crossover.jpg

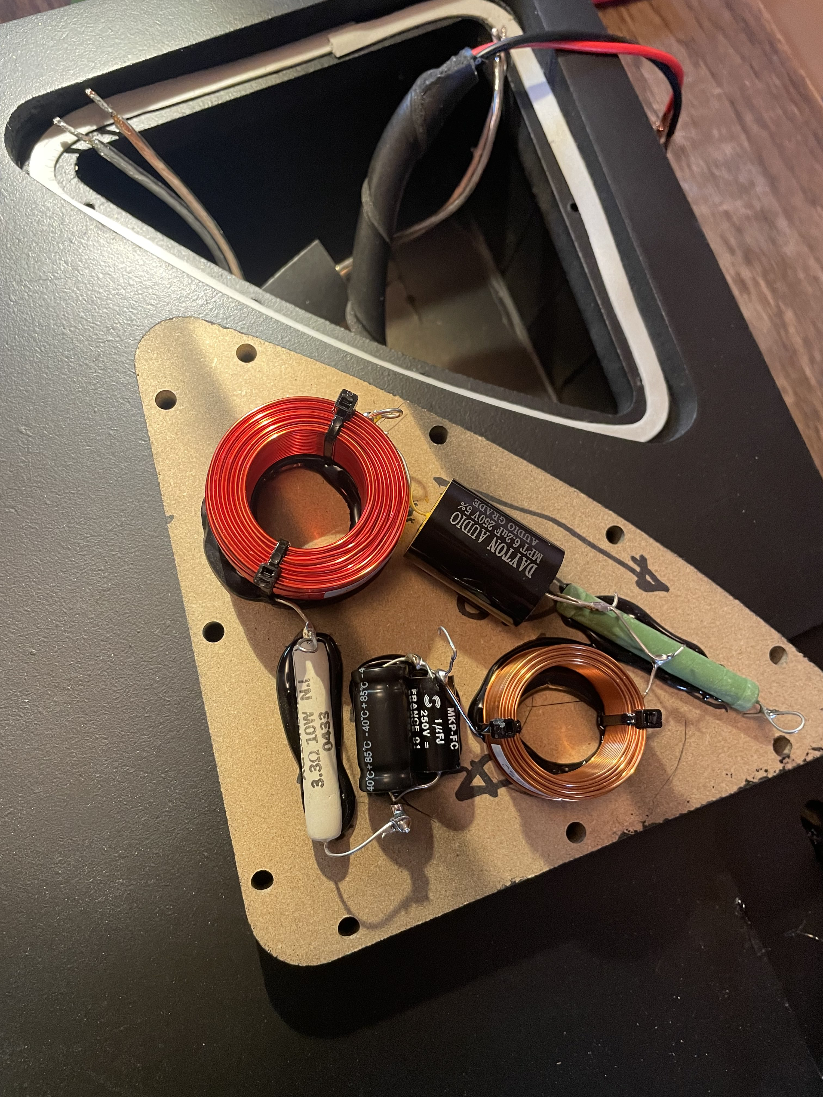
[picture p10: Photos/Main Photos/Surrounds Crossover.jpg]
Photos/Main Photos/Surrounds Crossover.jpg
